lusmdl/MySimRacingCore/README.md

# Sim Racing Core Controller
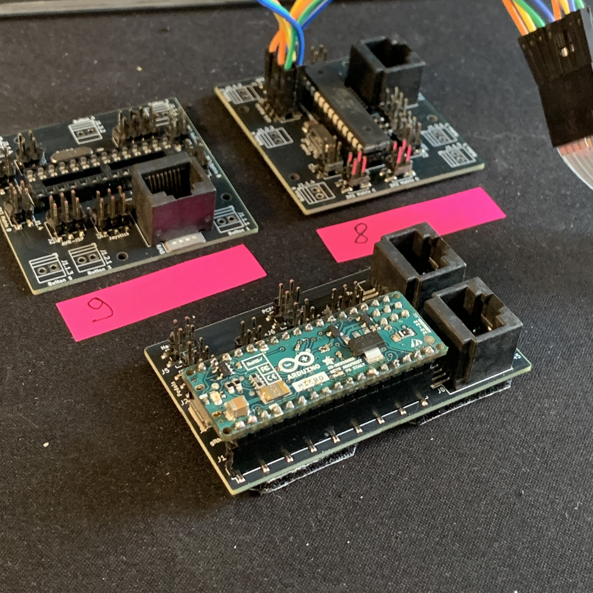
[picture p1: doc/hardware/Pictures/real PCBAs.jpg]
Real PCBA´s


Welcome to the Sim Racing Core Controller repository!

This project focuses on programming the ATmega32u4 microcontroller to serve as the core of a high-performance sim racing setup. 
The controller independently handles all tasks, including steering, pedals, and accessory management, ensuring a streamlined and immersive racing experience—all without external setup software.

Other projects require PC-based software. 
This solution does everything directly on the microcontroller. 
Sensor calibration, configuration, and adjustments are all handled locally and stored in the microcontroller’s memory. 
The system can be operated intuitively via a simple interface.

This repository is designed to prioritize simplicity and reliability, with clean, maintainable code that’s easy to understand and adapt to your needs.

## Features

- 32 buttons (includes joystick button (1) for setup)
- Steering-Axis without FFB (Steering)
- Accelerate-Axis
- Brake-Axis
- X-Rotation-Axis (Joystick)
- Y-Rotation-Axis (Joystick)

## Getting Started

### Hardware Requirements

- **ATmega32u4 Microcontroller**: I use the original arduino micro board
- **Steering Wheel**: I use a cheap optical encoder with A and B line from china
- **Pedals**: I use a old xbox360 racing wheel pedal set. It only needs to work with potis.
- **Buttons**: The microcontroller get the 16 bit data from I2C Interface Adress 8 & 9 button data. You need a diffrent device for this. Look at my other project [here](https://github.com/lusmdl/MySimRacingButtonBox)!
- **Joystick**: I use a "normal" joystick from the Sony DualShock series and have designed a custom PCB to integrate it seamlessly. Special thanks to [little-scale](https://github.com/little-scale) for providing the [PS4 joystick footprint](https://github.com/little-scale/PS4_joystick_footprint), which served as the foundation for my design.
- **LCD**: I use a Arduino Uno with a LCD 2x16 shield. Look at this project [here](https://github.com/lusmdl/MySimRacingSetupDisplay).

> Example PCBs for this project
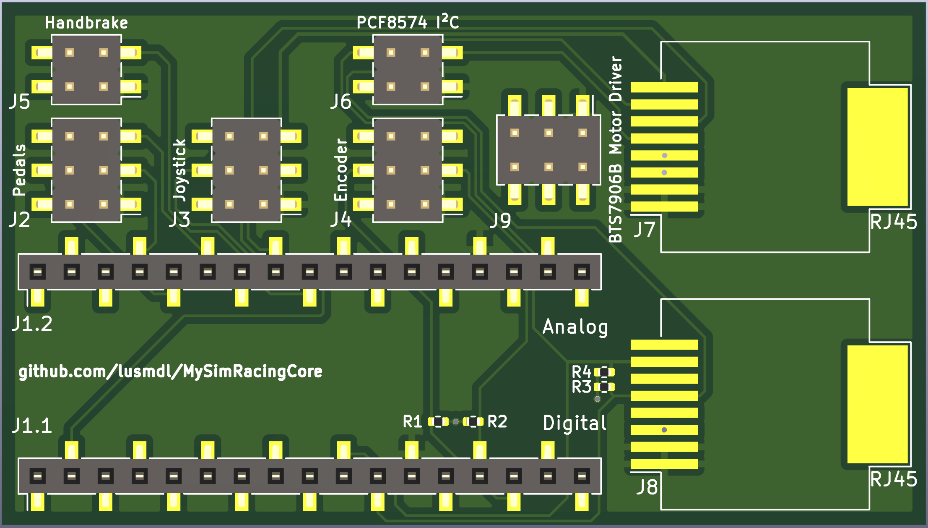
[picture p2: doc/hardware/Pictures/PCBA.png]

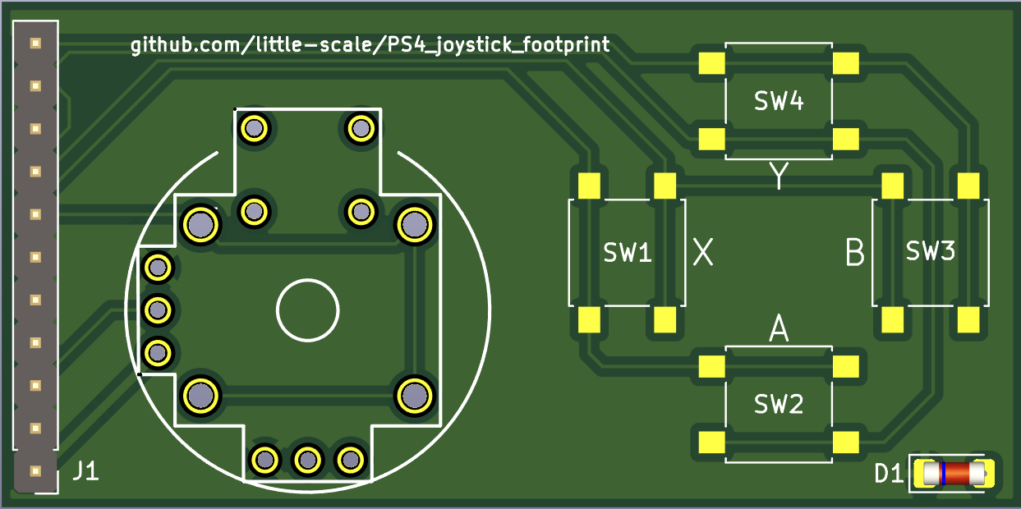
[picture p3: doc/hardware/Pictures/joystick-_PCBA.png]

KiCad-PCB-Design

### Software Requirements

- [**Platform IO**](https://platformio.org/install/ide?install=vscode): Used for programming the ATmega32u4 microcontroller.
- [**AVR Lib**](https://github.com/avrdudes/avr-libc.git): standard lib for programming atmega microcontrollers with platformIO.
- [**Arduino AVR Core**](https://github.com/arduino/ArduinoCore-avr.git): used `Arduino.h`, `Wire.h` and `EEPROM.h`
- [**Arduino Joystick With Force Feedback Library**](https://github.com/YukMingLaw/ArduinoJoystickWithFFBLibrary.git): used for USB communication with the game

### Software Installation and Setup

> You can use the pre compiled hex file. Or you compile it yourself.

1. **Install PlatformIO**:
- Follow the [installation guide](https://platformio.org/install) to set up PlatformIO in your preferred environment (VSCode, Atom, etc.).

2. **Clone the Repository**:

```sh
git clone https://github.com/lusmdl/MySimRacingCore.git
```

3. **Open the Project**:
- Open the cloned repository folder in your PlatformIO environment.

4. **Build and Upload**:
- Connect your Arduino Micro.
- Build and upload the code using PlatformIO:

```sh
pio run --target upload
```

### Hardware Setup

To get started, you’ll need to assemble the accessories and adapt them to the Arduino Micro.

Special attention is required for the I2C interface and the encoder, as proper pull-up resistors are essential for reliable operation. 
To simplify this process, I’ve designed a custom PCB that integrates the Arduino Micro with all necessary accessories and I2C clients.

## Usage

1. **Connecting the Hardware**:
- Connect the accessorys to the Arduino Micro as per your configuration.
- Connect the Arduino Micro to the PC.

2. **Running the Code**:
- Power up your setup.
- The Arduino Micro will continuously push the accessorys states and update the Game data via USB.

3. **Setup the Wheelebase**
- Hit the joystick butten while booting..
- follow the instructions on the lcd

4. **Start your game and try it**

5. **Give feedback and report bugs**

## Documentation
- **Software**: [doc/software/html/index.html](/doc/software/html/index.html)

## Contributing

We welcome contributions from the community!

First, read the [general contributing conventions for projects from me](CONTRIBUTING.md).

1. Fork the repository.
2. Create a new branch (`git checkout -b feature-branch`).
3. Commit your changes (`git commit -am 'Add new feature'`).
4. Push to the branch (`git push origin feature-branch`).
5. Create a new Pull Request.

## License

This project is licensed under the MIT License - see the [LICENSE](LICENSE) file for details.
