lusmdl/MySimRacingCore/doc/hardware/Pin Header 2.54mm THT.pdf

# Artikel-Nr.: 10120184 Bez.: Stiftleiste 50 polig, vergoldet, Raster 2,54mm

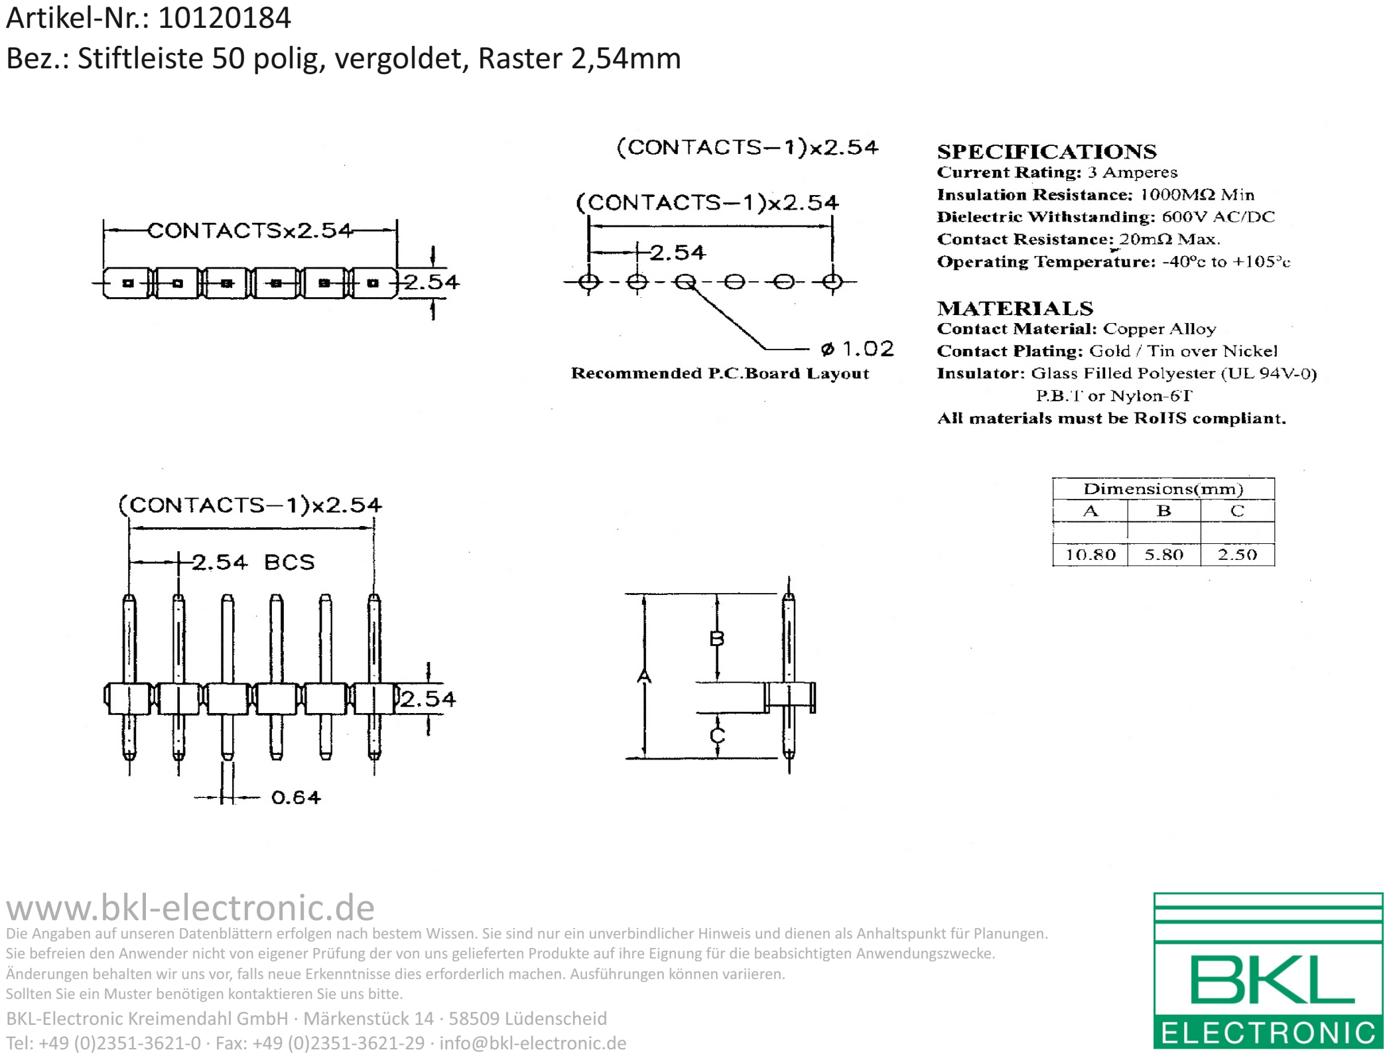
[picture p4: page 1]

# www.bkl-electronic.de

Die Angaben auf unseren Datenblättern erfolgen nach bestem Wissen. Sie sind nur ein unverbindlicher Hinweis und dienen als Anhaltspunkt für Planungen. Sie befreien den Anwender nicht von eigener Prüfung der von uns gelieferten Produkte auf ihre Eignung für die beabsichtigten Anwendungszwecke. Änderungen behalten wir uns vor, falls neue Erkenntnisse dies erforderlich machen. Ausführungen können variieren.
Sollten Sie ein Muster benötigen kontaktieren Sie uns bitte.

### BKL-Electronic Kreimendahl GmbH · Märkenstück 14 · 58509 Lüdenscheid Tel: +49 (0)2351-3621-0 · Fax: +49 (0)2351-3621-29 · info@bkl-electronic.de
