lusmdl/MySimRacingCore/doc/hardware/Socket Header 2.54mm SMD.pdf

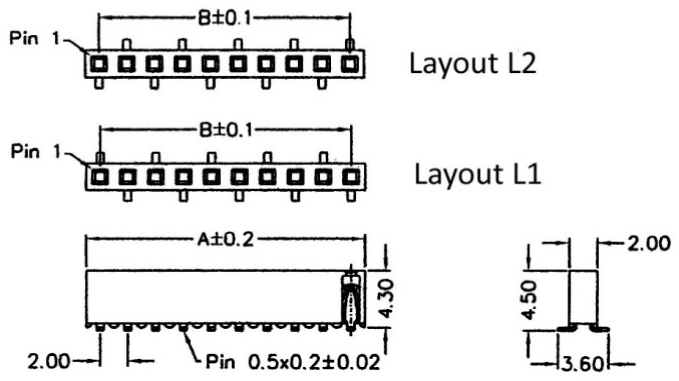
[picture p5: figure]
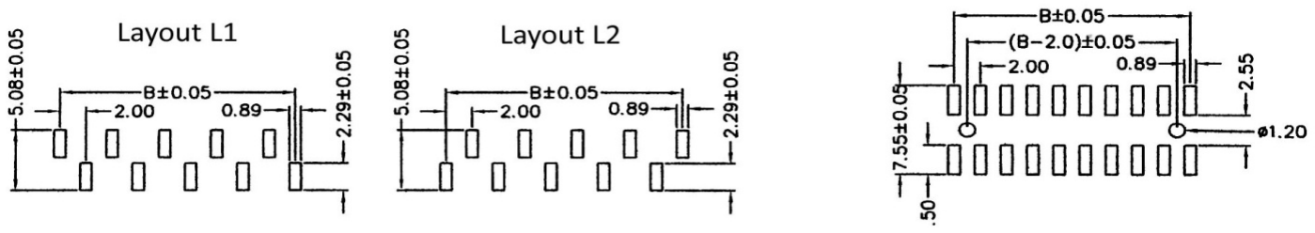
[picture p6: figure]

## Kurzbeschreibung:

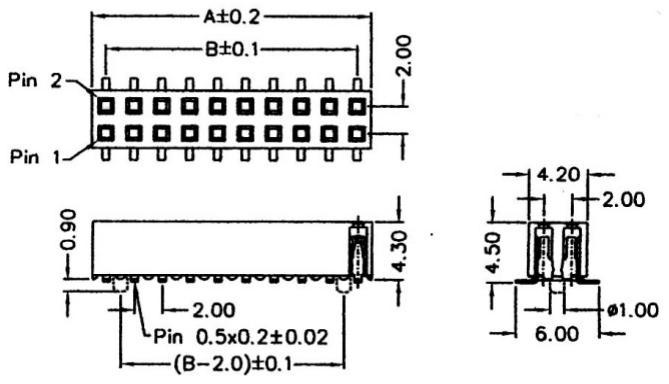
[picture p7: figure]

im Raster 2,00 mm und Bauhöhe = 4,3 mm. Für

## Technische Daten:

Polyester

packung, Tape & Reel

## Lieferform:

Pol, | CSGX, | S‐CSGD

## Passt zu:

S ‐ CP L G 43 | ‐ | ‐ | ‐ P / PP / T / TR

Polzahl pro Reihe (max 50)

‐

ELMEBA GmbH ‐ Am Heintges 9 ‐ D‐40885 Ratingen ‐ www.elmeba.com | Seite 55

Oberfläche: 1 = Verzinnt, 2 = Vergoldet

## SMD Buchsenleiste, RM=2,00 mm, BH= 4,3 mm, für □ 0,5 mm S‐CPLG43

## PCB Layout:

Ein‐ und zweireihige SMD Buchsenleiste
Kontakte □ 0,5 mm und bis max 40 Pole pro Reihe. Wir konfektionieren die Leiste in jede gewünschte Polzahl.
Isolationskörper: | >10 9 GF (UL 94 V‐0) | Isolationswiderstand: | Ω
Vierkantstift: | CuZn36Pb3 | Nennstrom: | 1 Ampere
Oberfläche: | Sn über Ni | Prüfspannung: | 500 V AC
| Au (Flash Au oder 0,75 µ Au) über Ni | Temperaturbereich: | .‐40°C … +105°C
Kontaktwiderstand: | < 10 m Ω | Lötwärmebeständigkeit | 235°C (30 ‐ 60 sec.)
‐ 1x3 ‐ 1x40 Pol, 2x2 ‐ 2x40 | S‐CSGX, CSGD,
‐ andere Raster: z.B. 4,00 mm, 6,00 mm usw | CSAX, S‐CSAX,

‐ jede gewünschte Sondercodierung möglich

‐ Optional: Positionierhilfe, Pick & Place Pads, Stangenver

## Bestellschlüssel:

Anzahl Reihen (1 ‐ 3)

Oberfläche: 1 = Verzinnt, 2 = Vergoldet

Optional: P = Positionierhilfe, PP = Pick & Place Pads, T = Stangenverpackung, TR = Tape & Reel
