lusmdl/MySimRacingCore/doc/hardware/Pin Header 2.54mm SMD.pdf

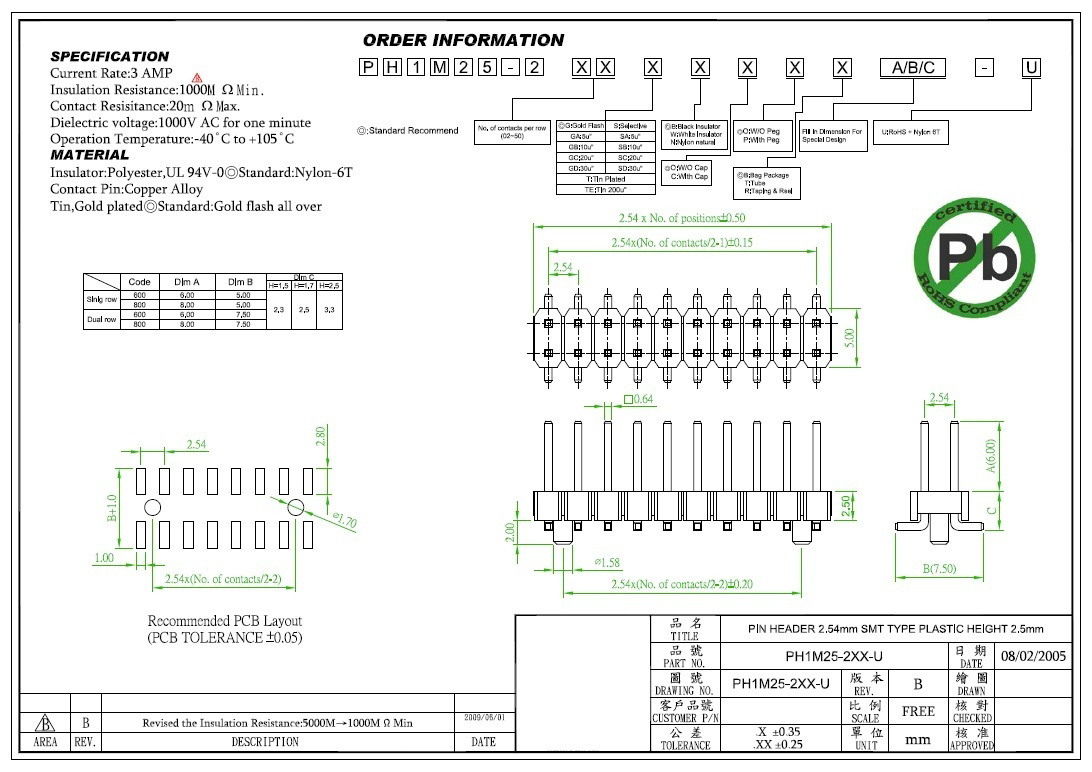
[picture p8: page 1]
