lusmdl/MySimRacingCore/doc/hardware/Hall effect sticks.png

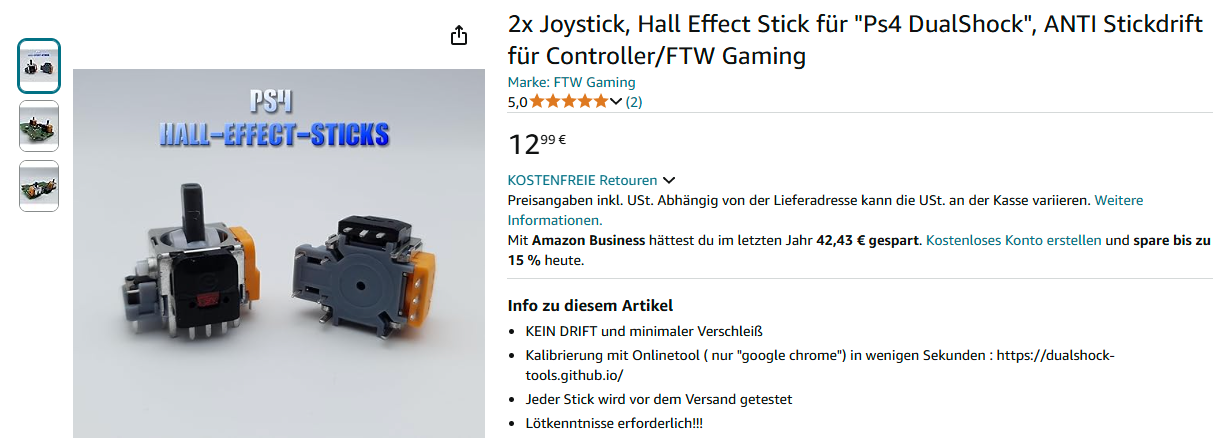
doc/hardware/Hall effect sticks.png
