lusmdl/MySimRacingCore/doc/hardware/HJC0272-011024.pdf

目　　次

## Contents

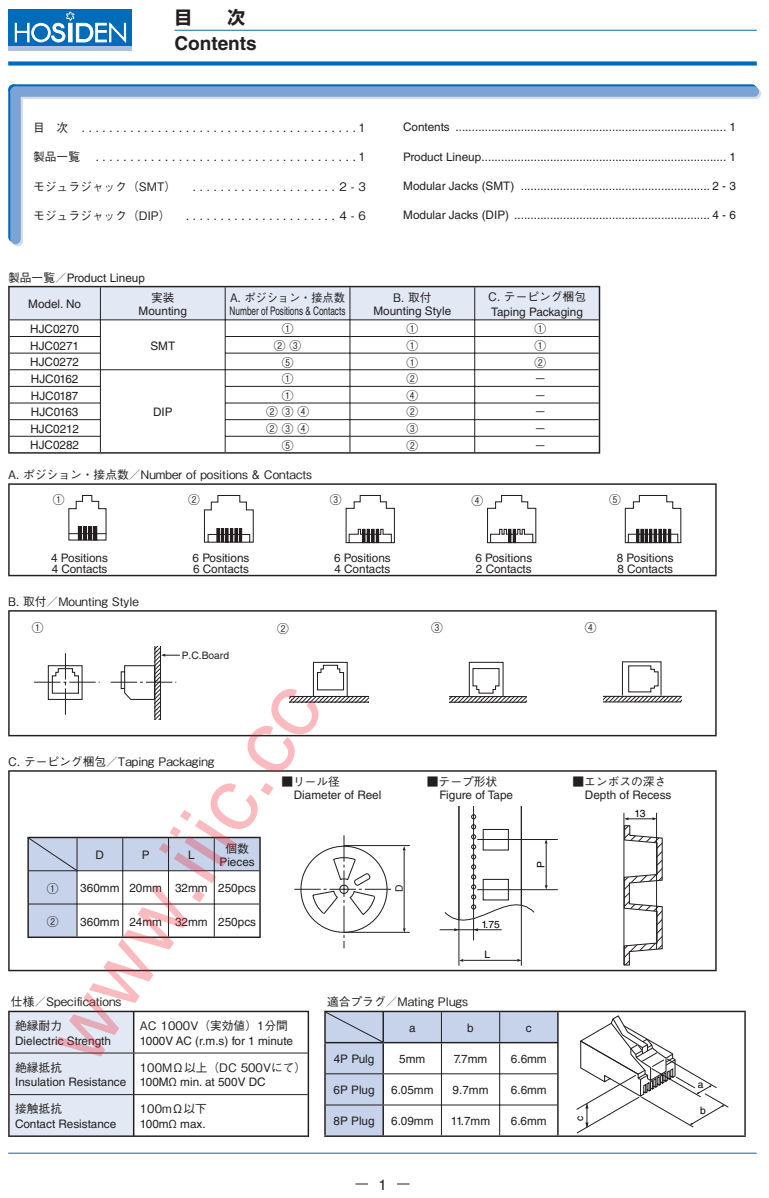
[picture p10: page 1]
絶縁耐力 Dielectric Strength; 絶縁抵抗 Insulation Resistance; 接触抵抗 Contact Resistance; 100mΩ以下 100mΩ max.; モジュラジャック（SMT） . . . . . . . . . . . . . . . . . . . . . 2 - 3; モジュラジャック（DIP） . . . . . . . . . . . . . . . . . . . . . . 4 - 6; 4 Positions 4 Contacts; 6 Positions 6 Contacts; 6 Positions 4 Contacts; 6 Positions 2 Contacts; 8 Positions 8 Contacts; P.C.Board

Modular Jacks (SMT) .......................................................... 2 - 3

Modular Jacks (DIP) ............................................................ 4 - 6

製品一覧／Product Lineup

Model. No | 実装 Mounting | A. ポジション・接点数 Number of Positions & Contacts | B. 取付 Mounting Style | C. テーピング梱包 Taping Packaging

HJC0270 | SMT | ① | ① | ①
HJC0271 | | ② ③ | ① | ①
HJC0272 | | ⑤ | ① | ②
HJC0162 | DIP | ① | ② | －
HJC0187 | | ① | ④ | －
HJC0163 | | ② ③ ④ | ② | －
HJC0212 | | ② ③ ④ | ③ | －
HJC0282 | | ⑤ | ② | －

A. ポジション・接点数／Number of positions & Contacts
13 www.iiic.cc

B. 取付／Mounting Style

C. テーピング梱包／Taping Packaging

■リール径
Diameter of Reel

■テープ形状
Figure of Tape

■エンボスの深さ
Depth of Recess

D | P | L | 個数 Pieces

① | 360mm | 20mm | 32mm | 250pcs

② | 360mm | 24mm | 32mm | 250pcs

仕様／Specifi cations

適合プラグ／Mating Plugs

AC 1000V（実効値）1分間
1000V AC (r.m.s) for 1 minute

4P Pulg | 5mm | 7.7mm | 6.6mm

100MΩ以上（DC 500Vにて）
100MΩ min. at 500V DC

6P Plug | 6.05mm | 9.7mm | 6.6mm

8P Plug | 6.09mm | 11.7mm | 6.6mm

## モジュラジャック（SMT）

## Modular Jacks (SMT)

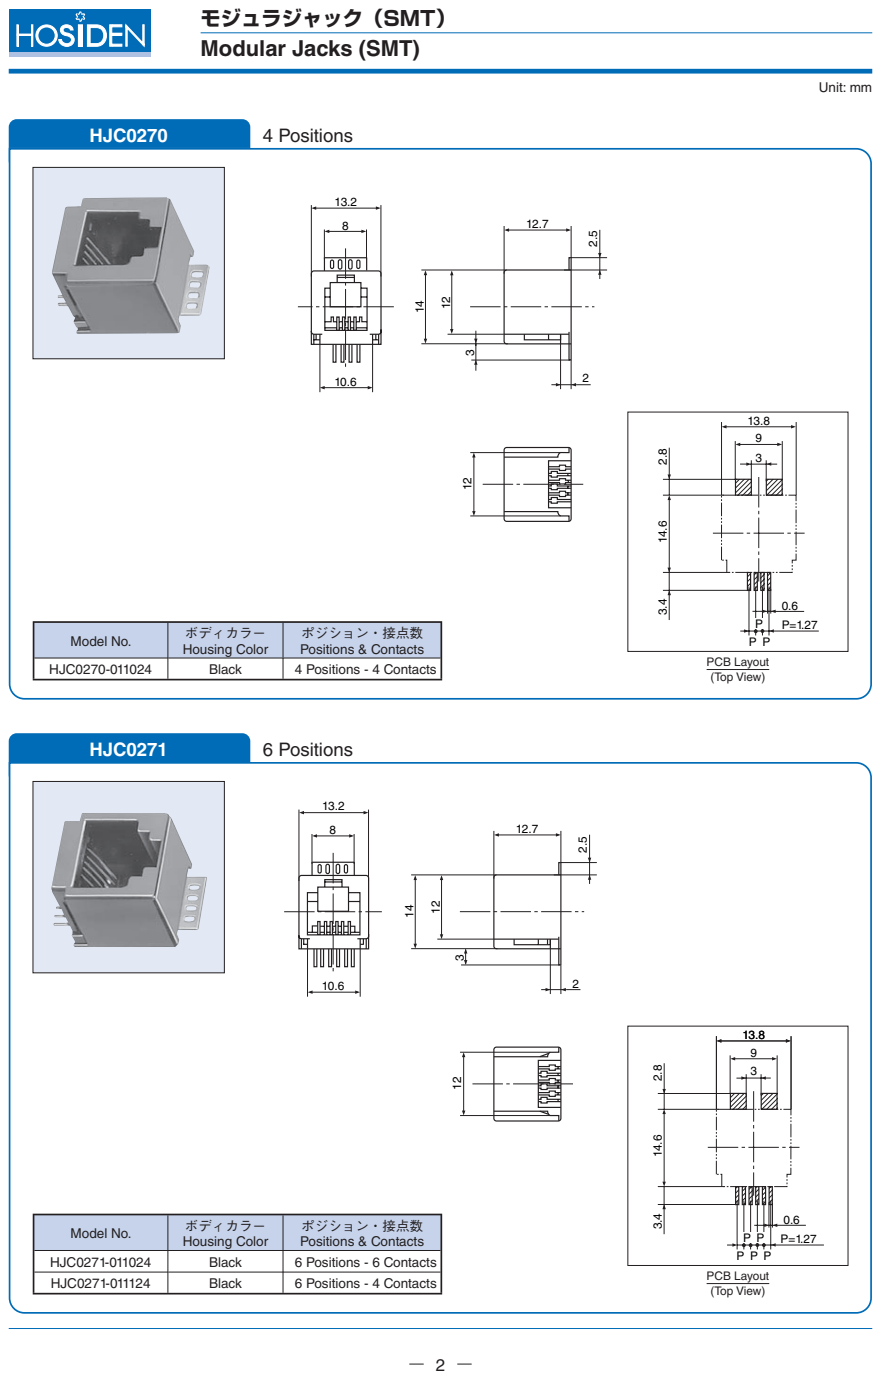
[picture p11: page 2]
Unit: mm; HJC0271; PCB Layout (Top View); HJC0270; 4 Positions; 6 Positions

Model No. | ボディカラー Housing Color | ポジション・接点数 Positions & Contacts

HJC0270-011024 | Black 4 Positions - 4 Contacts

HJC0271-011024 | Black | 6 Positions - 6 Contacts
HJC0271-011124 | Black | 6 Positions - 4 Contacts

## モジュラジャック（SMT）

## Modular Jacks (SMT)

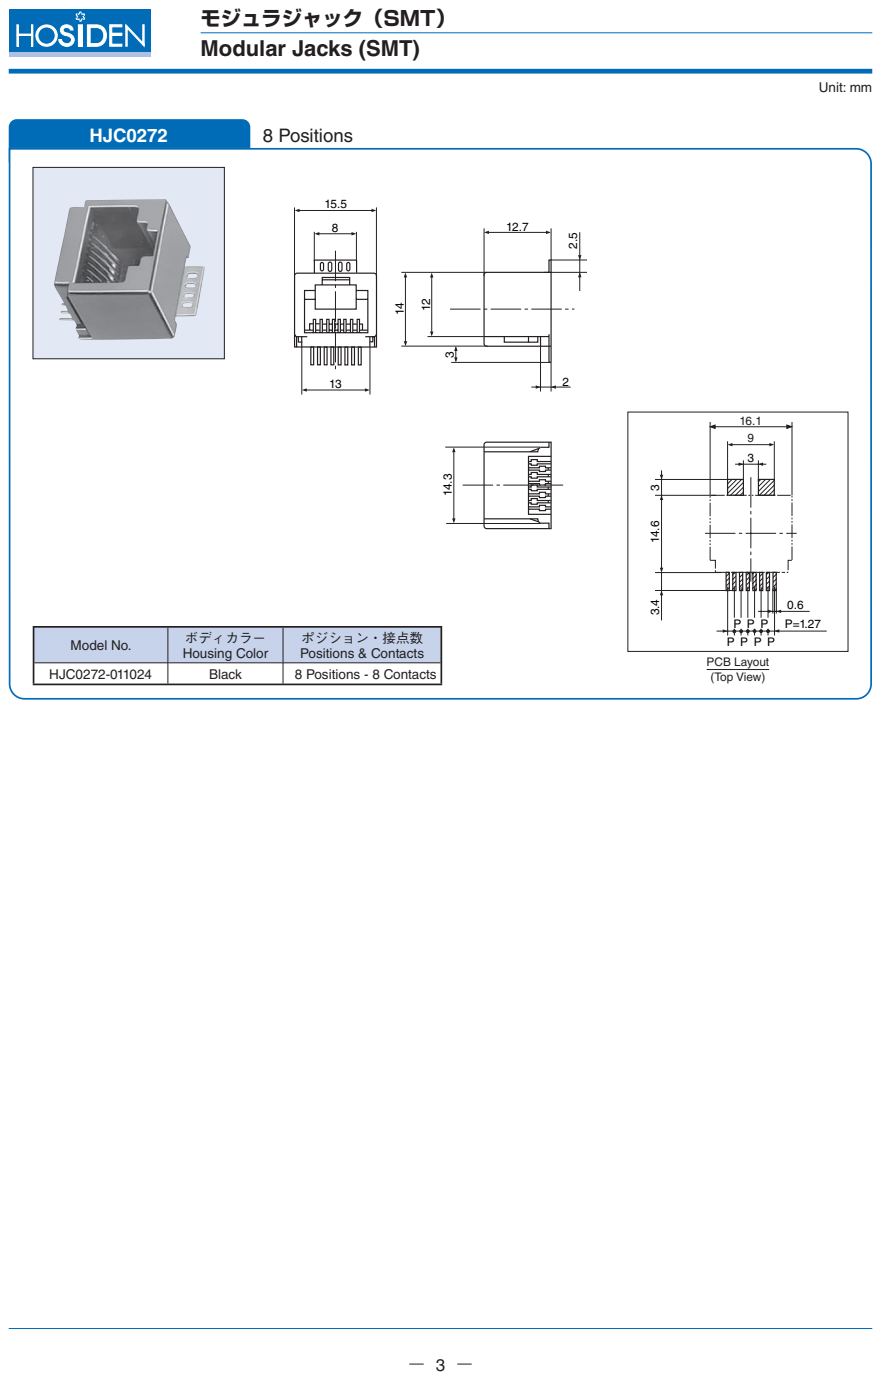
[picture p12: page 3]
8 Positions; HJC0272; PCB Layout (Top View)

Model No. | ボディカラー Housing Color | ポジション・接点数 Positions & Contacts

HJC0272-011024 | Black 8 Positions - 8 Contacts

## モジュラジャック（DIP）

## 4 Positions

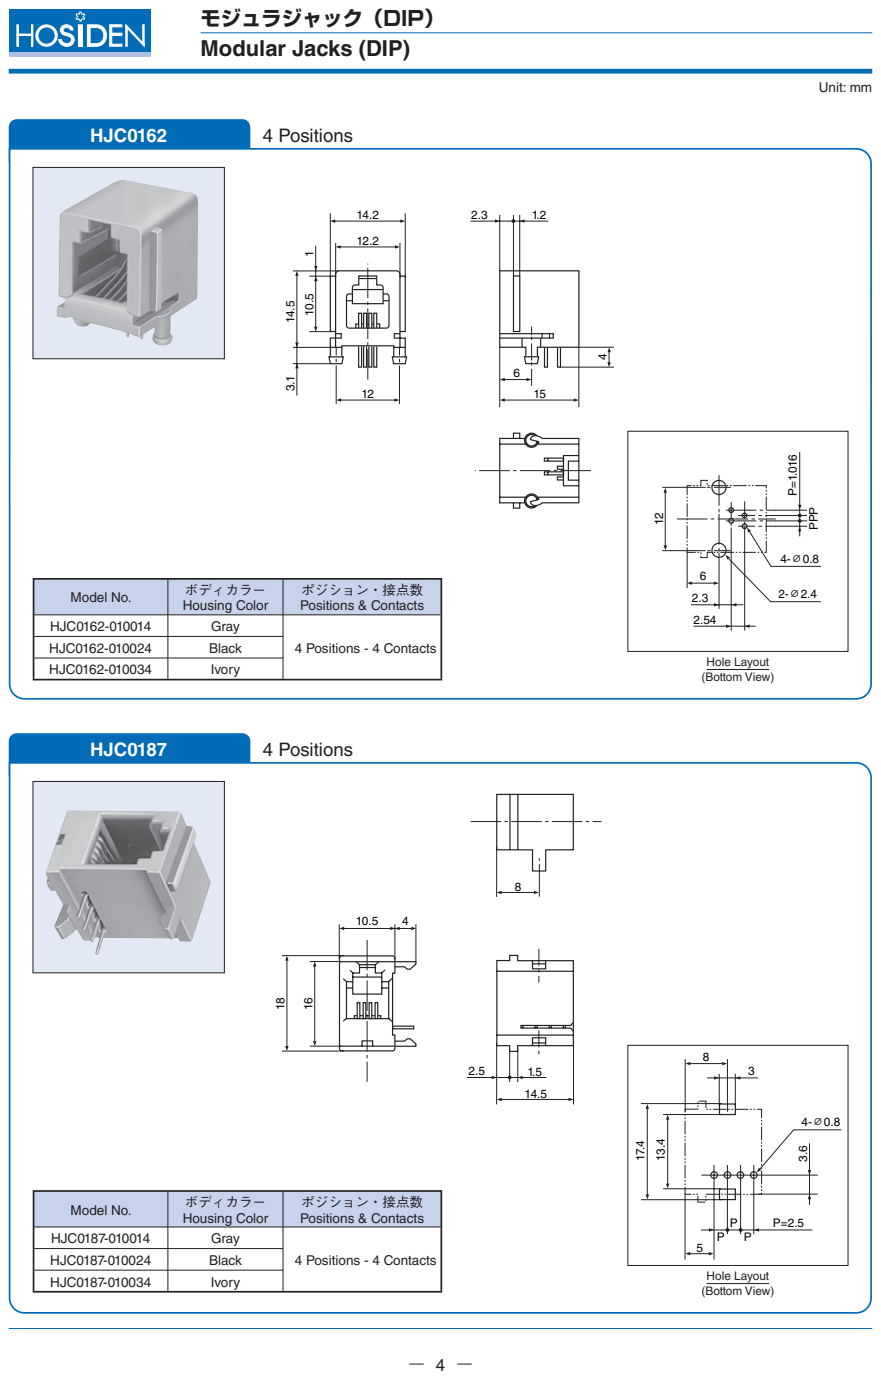
[picture p13: page 4]
Modular Jacks (DIP) 14.5; HJC0162; HJC0187; Hole Layout (Bottom View); 4 Positions

Model No. | ボディカラー Housing Color | ポジション・接点数 Positions & Contacts

HJC0162-010014 | Gray | 4 Positions - 4 Contacts
HJC0162-010024 | Black
HJC0162-010034 | Ivory

HJC0187-010014 | Gray | 4 Positions - 4 Contacts
HJC0187-010024 | Black
HJC0187-010034 | Ivory

## Modular Jacks (DIP)

## 6 Positions

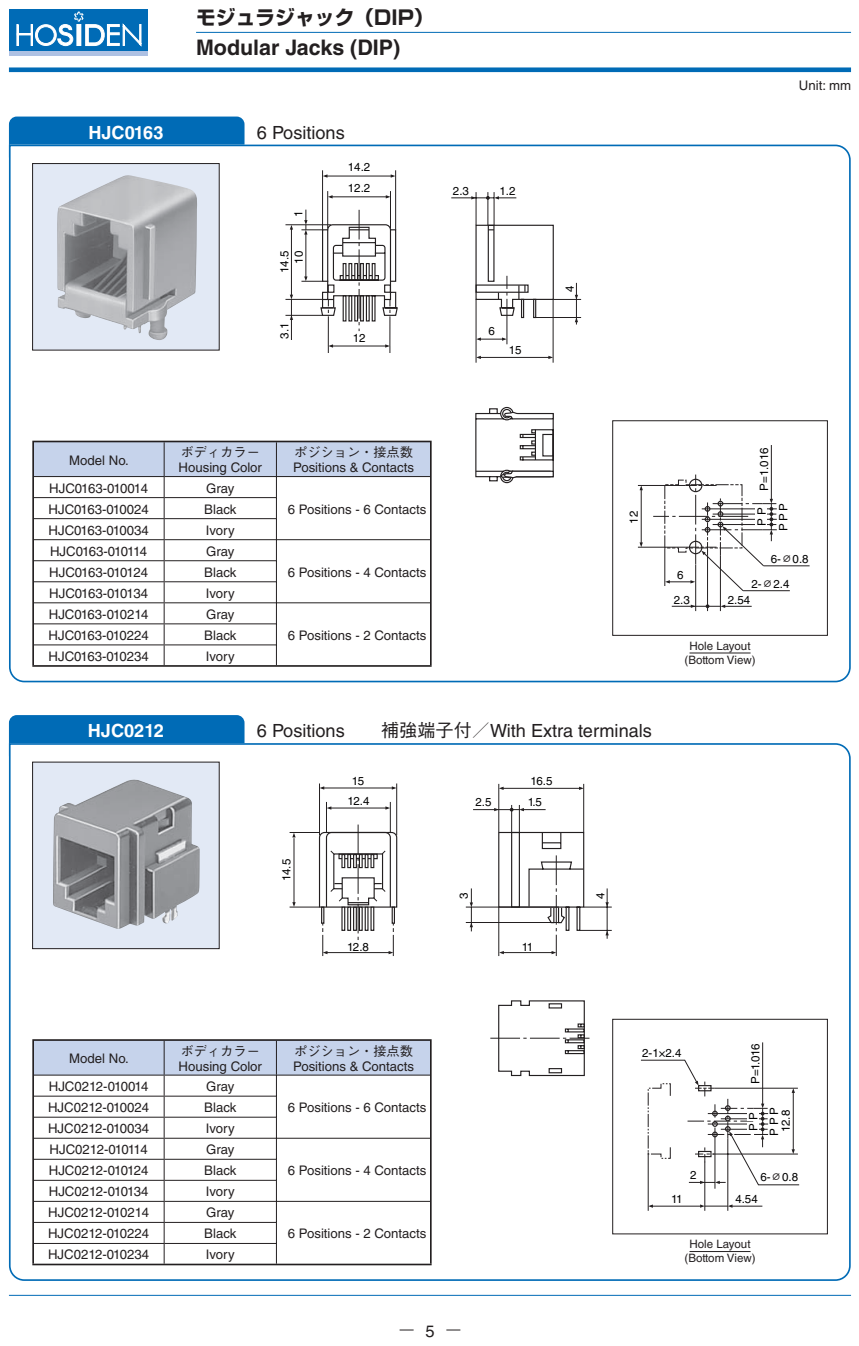
[picture p14: page 5]
HJC0163; HJC0212; 6 Positions 補強端子付／With Extra terminals; Hole Layout (Bottom View)

Model No. | ボディカラー Housing Color | ポジション・接点数 Positions & Contacts

HJC0163-010014 | Gray | 6 Positions - 6 Contacts
HJC0163-010024 | Black
HJC0163-010034 | Ivory
HJC0163-010114 | Gray | 6 Positions - 4 Contacts
HJC0163-010124 | Black
HJC0163-010134 | Ivory
HJC0163-010214 | Gray | 6 Positions - 2 Contacts
HJC0163-010224 | Black
HJC0163-010234 | Ivory

HJC0212-010014 | Gray | 6 Positions - 6 Contacts
HJC0212-010024 | Black
HJC0212-010034 | Ivory
HJC0212-010114 | Gray | 6 Positions - 4 Contacts
HJC0212-010124 | Black
HJC0212-010134 | Ivory
HJC0212-010214 | Gray | 6 Positions - 2 Contacts
HJC0212-010224 | Black
HJC0212-010234 | Ivory

## Modular Jacks (DIP)

HJC0282 | 8 Positions

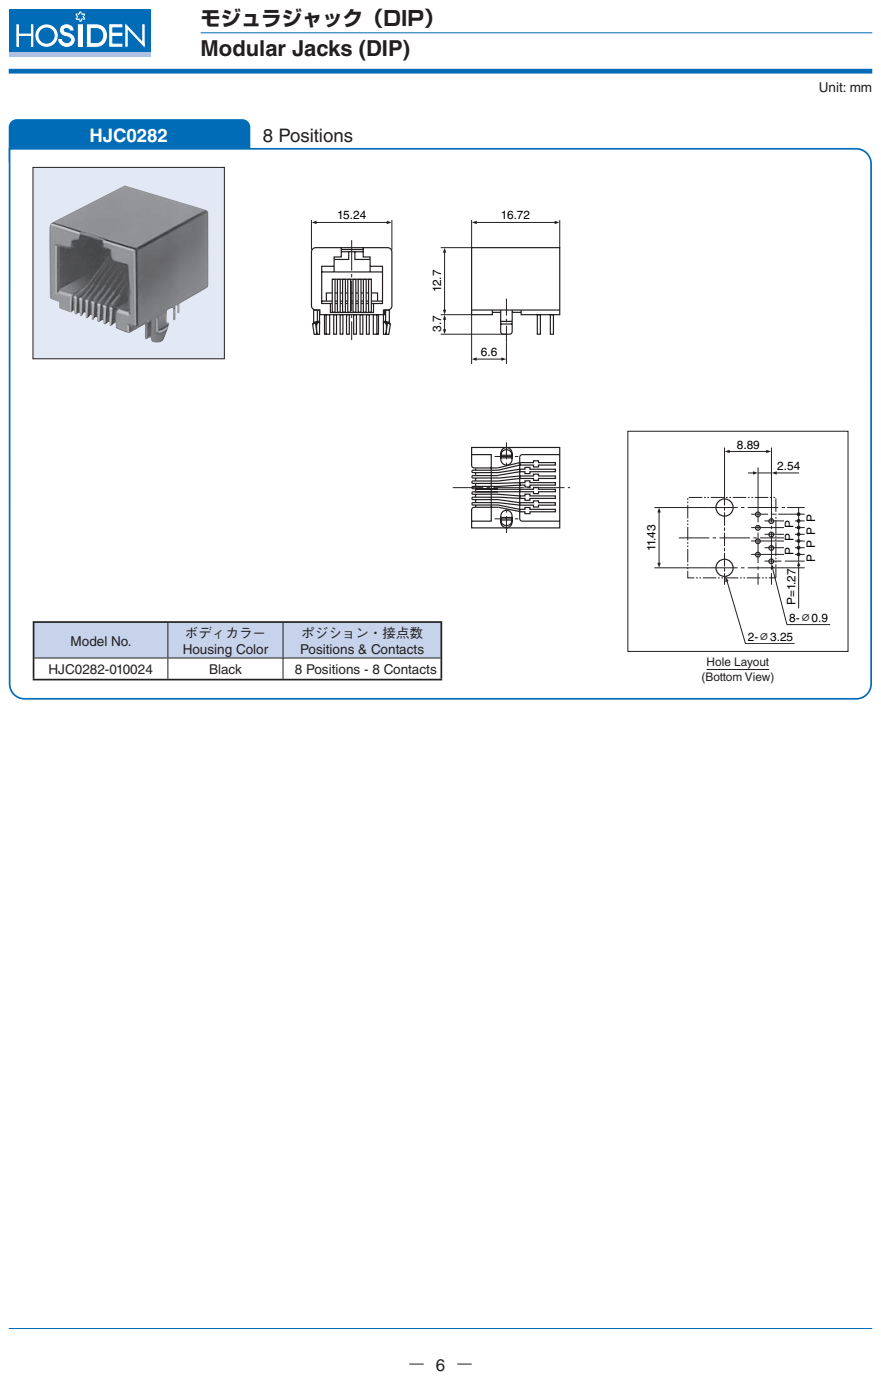
[picture p15: page 6]
Hole Layout (Bottom View)

Model No. | ボディカラー Housing Color | ポジション・接点数 Positions & Contacts

HJC0282-010024 | Black 8 Positions - 8 Contacts

ご使用の際は、納入仕様書を確認の上、正しく お使いください。 | Please use our products properly based on our Drawing and Specification.

### JC06 モジュラジャック

Modular Jacks

### ■Model No. Table

Model No. | Page
H J C 0 1 6 2 | 4
H J C 0 1 6 3 | 5
H J C 0 1 8 7 | 4
H J C 0 2 1 2 | 5
H J C 0 2 7 0 | 2
H J C 0 2 7 1 | 2
H J C 0 2 7 2 | 3
H J C 0 2 8 2 | 6
