lusmdl/MySimRacingCore/doc/hardware/Micro_Rev1j_sch.pdf

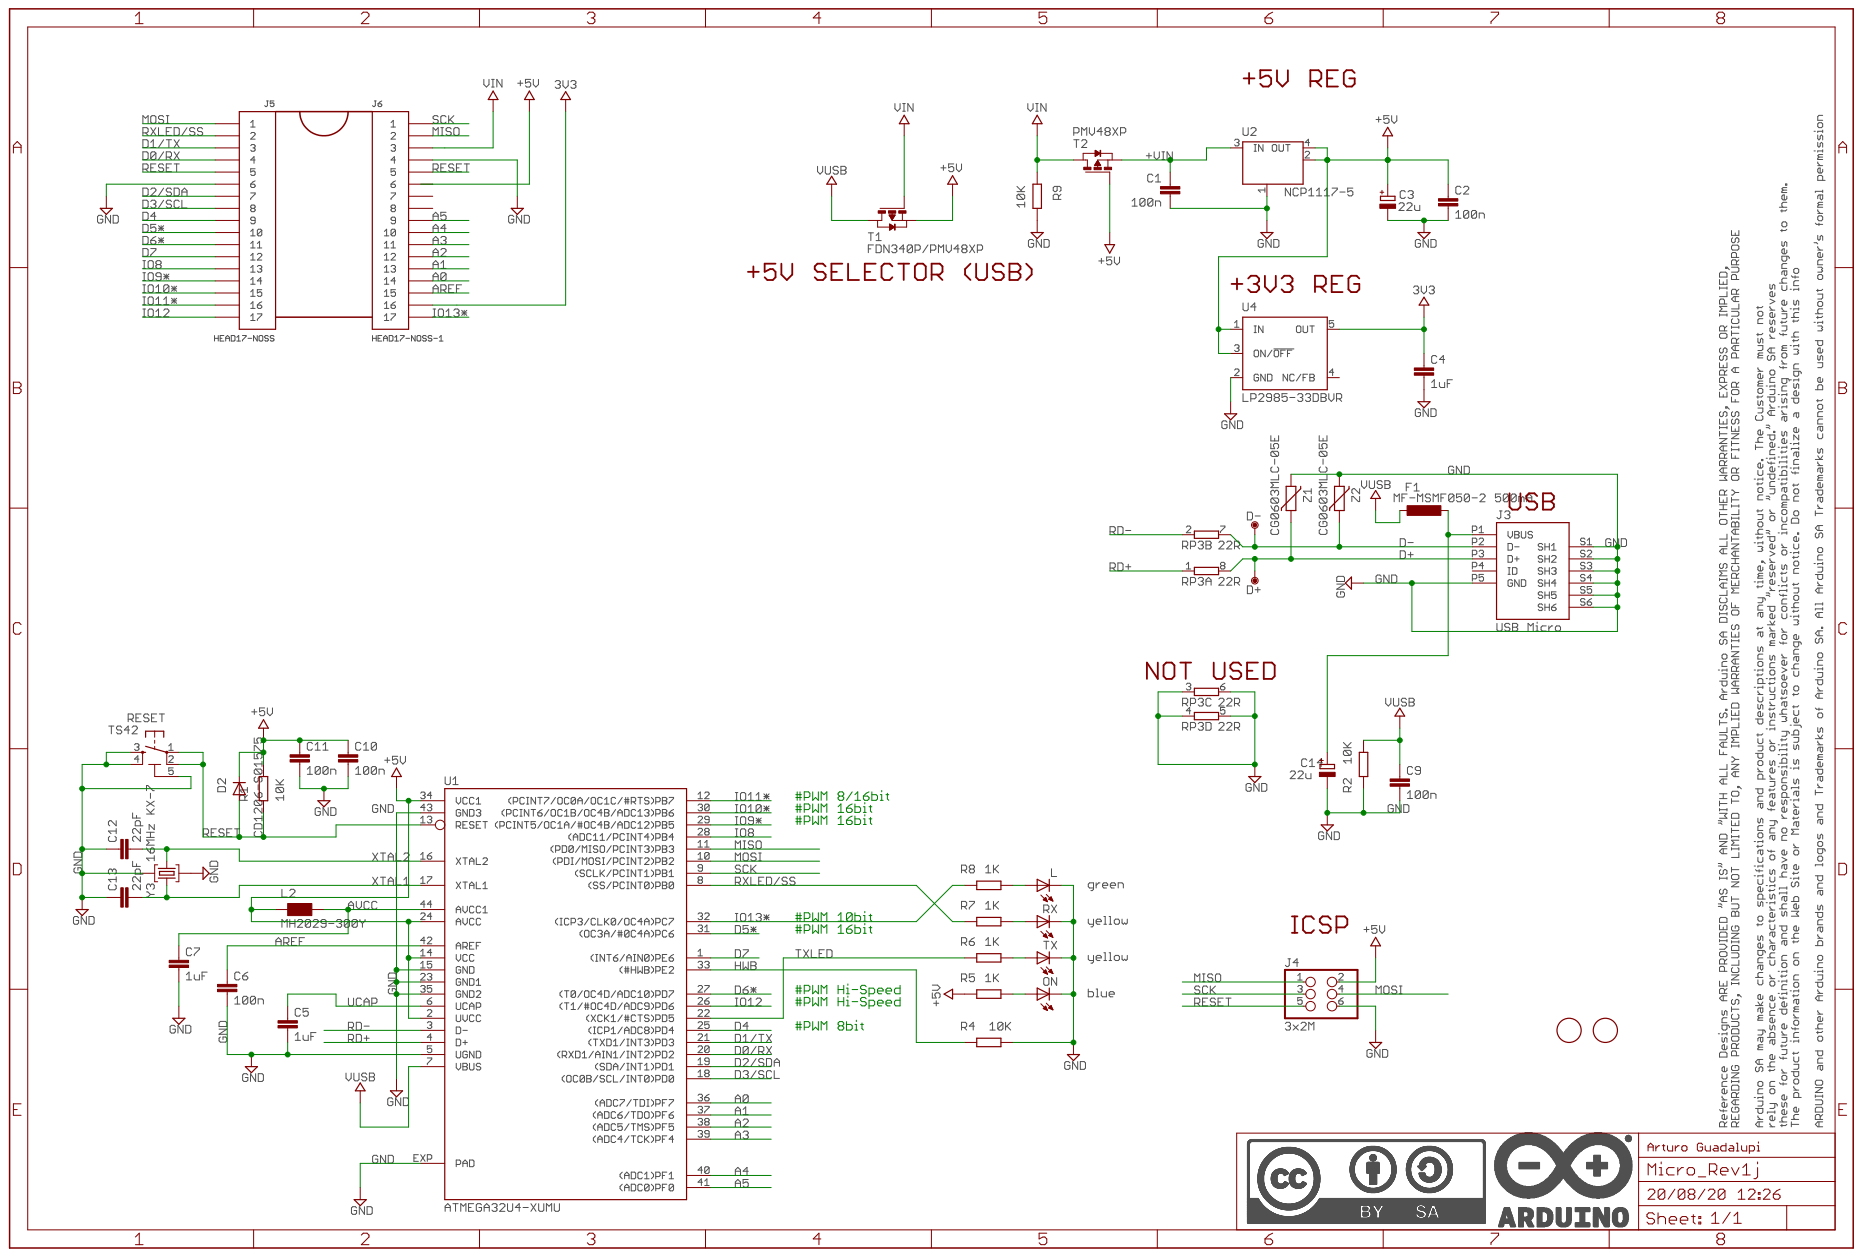
[picture p16: page 1]
