lusmdl/MySimRacingCore/kicad/circuit/circuit.kicad_pcb

## KiCad design kicad/circuit/circuit.kicad_pcb (2025-05-10)

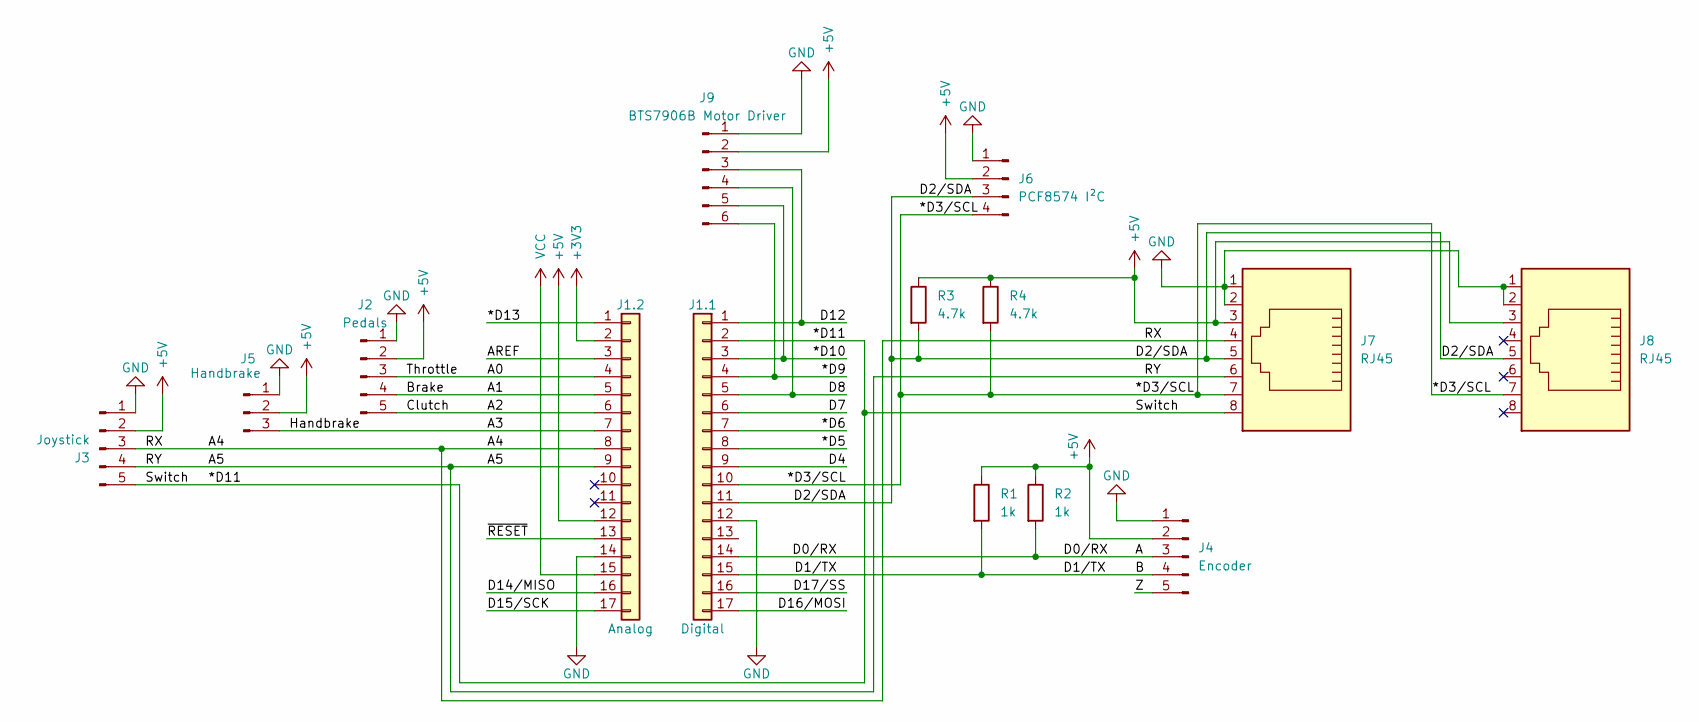
[picture p17: schematic circuit.kicad_sch, Arduino Micro Board]

Parts:
J1.1: Digital; PinSocket_1x17_P2.54mm_Vertical_SMD_Pin1Left
J1.2: Analog; PinSocket_1x17_P2.54mm_Vertical_SMD_Pin1Left
J2: Pedals; PinHeader_2x03_P2.54mm_Vertical_SMD
J3: Joystick; PinHeader_2x03_P2.54mm_Vertical_SMD
J4: Encoder; PinHeader_2x03_P2.54mm_Vertical_SMD
J5: Handbrake; PinHeader_2x02_P2.54mm_Vertical_SMD
J6: PCF8574 I²C; PinHeader_2x02_P2.54mm_Vertical_SMD
J7, J8: RJ45; RJ45_Molex_0855135013_Vertical
J9: BTS7906B Motor Driver; PinHeader_2x03_P2.54mm_Vertical_SMD
R1, R2: 1k; R_0402_1005Metric
R3, R4: 4.7k; R_0402_1005Metric

Connections:
+3V3: J1.2.2
+5V: J1.2.12, J2.2, J3.2, J4.2, J5.2, J6.2, J7.3, J8.3, J9.2, R1.1, R2.1, R3.1, R4.1
/*D3/SCL: J1.1.10, J6.4, J7.7, J8.7, R4.2
/*D5: J1.1.8
/*D6: J1.1.7
/*D9: J1.1.4, J9.6
/*D10: J1.1.3, J9.5
/*D11: J1.1.2, J3.5, J7.8
/*D13: J1.2.1
/A: J1.1.14, J4.3, R2.2
/A0: J1.2.4, J2.3
/A1: J1.2.5, J2.4
/A2: J1.2.6, J2.5
/A3: J1.2.7, J5.3
/A4: J1.2.8, J3.3, J7.4
/A5: J1.2.9, J3.4, J7.6
/AREF: J1.2.3
/B: J1.1.15, J4.4, R1.2
/D2/SDA: J1.1.11, J6.3, J7.5, J8.5, R3.2
/D4: J1.1.9
/D7: J1.1.6
/D8: J1.1.5, J9.4
/D12: J1.1.1, J9.3
/D14/MISO: J1.2.16
/D15/SCK: J1.2.17
/D16/MOSI: J1.1.17
/D17/SS: J1.1.16
/Z: J4.5
/~RESET: J1.2.13
GND: J1.1.12, J1.2.14, J2.1, J3.1, J4.1, J5.1, J6.1, J7.1, J7.2, J8.1, J8.2, J9.1
VCC: J1.2.15

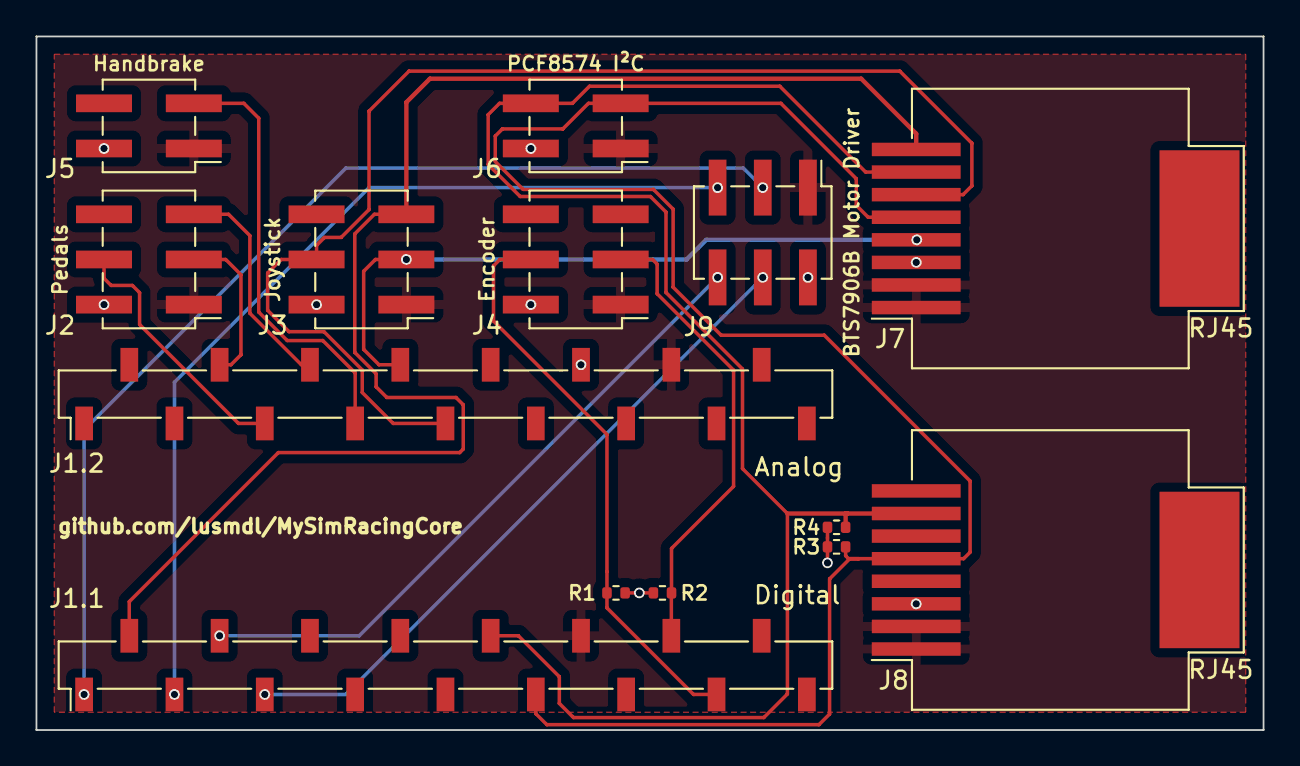
[picture p18: board circuit.kicad_pcb from above]

Board: 2 copper layers, 69.0 x 39.0 mm, 14 parts (0 on the bottom side), 17 nets.
