lusmdl/MySimRacingCore/kicad/PS4_joystick_footprint/ps4.kicad_pcb

## KiCad design kicad/PS4_joystick_footprint/ps4.kicad_pcb (2025-05-10)

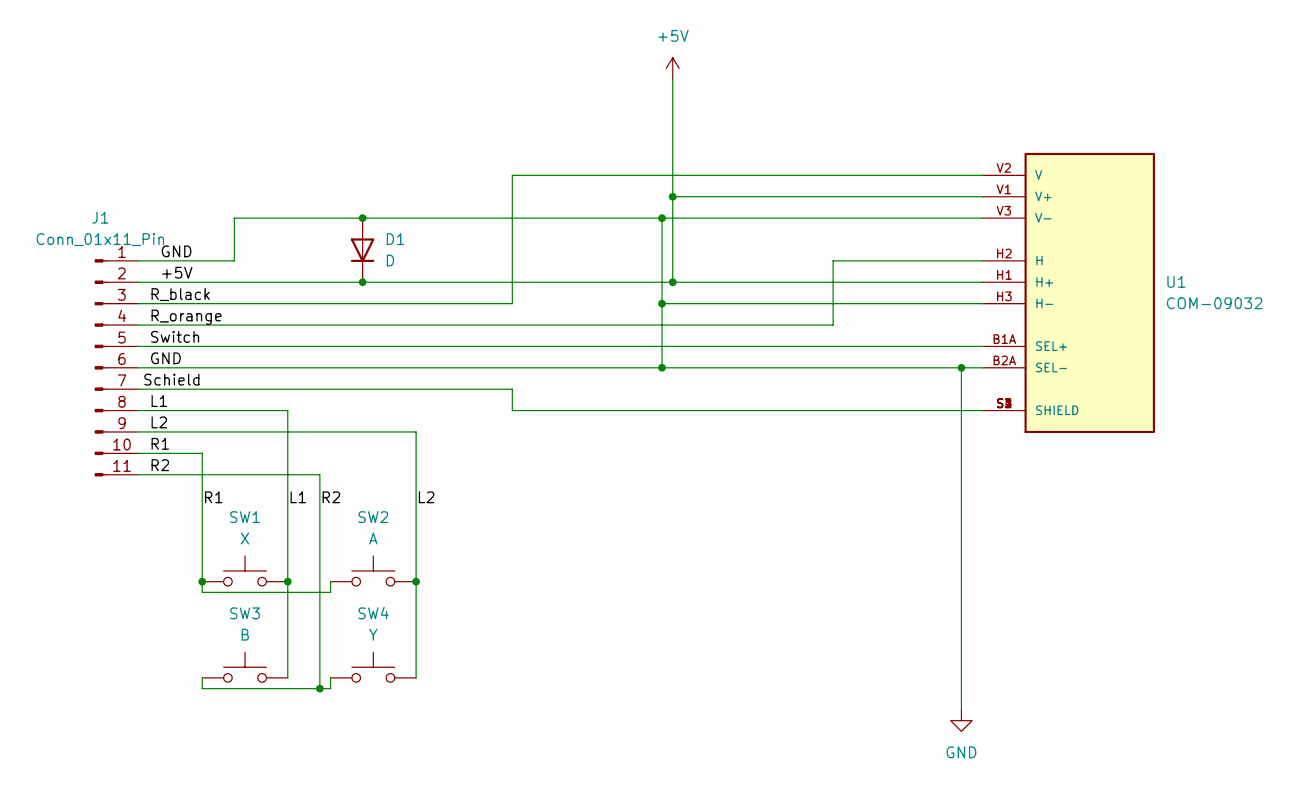
[picture p19: schematic ps4.kicad_sch, PS4 Joystick with buttons PCB]

Parts:
D1: D; D_MiniMELF
J1: Conn_01x11_Pin; PinHeader_1x11_P2.54mm_Vertical
SW1: X; SW_SPST_B3S-1000
SW2: A; SW_SPST_B3S-1000
SW3: B; SW_SPST_B3S-1000
SW4: Y; SW_SPST_B3S-1000
U1: COM-09032; PS4_joystick; PARTREV N/A

Connections:
+5V: D1.1 (K), J1.2, U1.H1 (H+), U1.V1 (V+)
/L1: J1.8, SW1.2, SW3.2
/L2: J1.9, SW2.2, SW4.2
/R1: J1.10, SW1.1, SW2.1
/R2: J1.11, SW3.1, SW4.1
/R_black: J1.3, U1.V2 (V)
/R_orange: J1.4, U1.H2 (H)
/Schield: J1.7, U1.S1 (SHIELD), U1.S2 (SHIELD), U1.S3 (SHIELD), U1.S4 (SHIELD)
/Switch: J1.5, U1.B1A (SEL+)
GND: D1.2 (A), J1.1, J1.6, U1.B2A (SEL-), U1.H3 (H-), U1.V3 (V-)

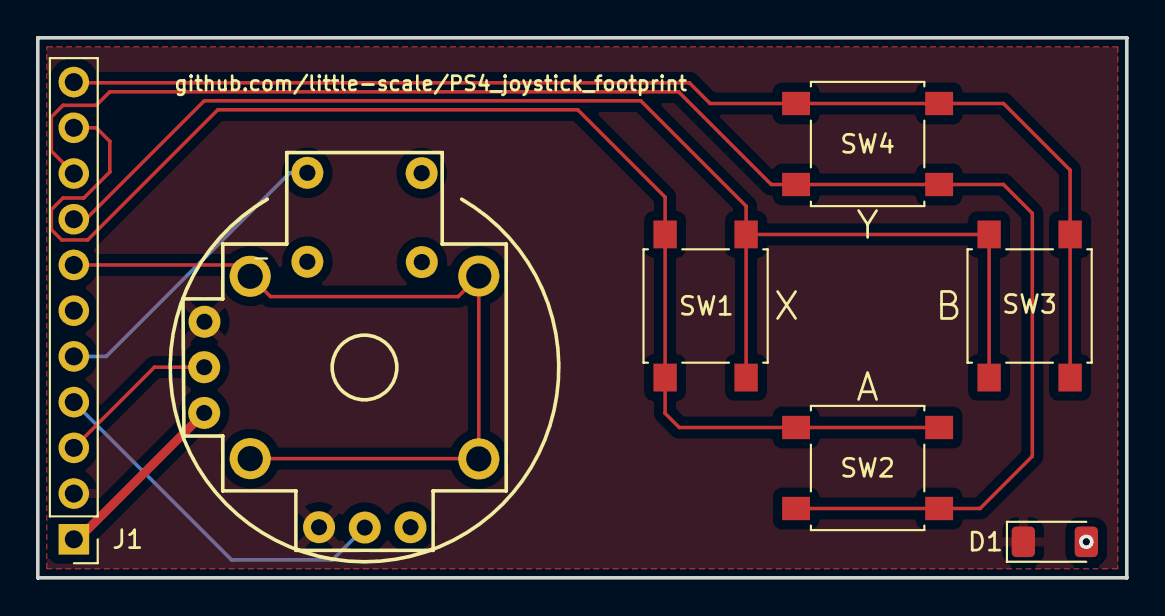
[picture p20: board ps4.kicad_pcb from above]

Board: 2 copper layers, 60.5 x 30.0 mm, 7 parts (0 on the bottom side), 10 nets.
