lusmdl/MySimRacingCore/include/EepromAdresses.h

/**
 * @file EepromAdresses.h
 * 
 * @brief Definition of eeprom adresses
 */

 #ifndef EEPROM_ADRESSES_H
 #define EEPROM_ADRESSES_H

 #define STORE_ADDR_RX_MAX              0
 #define STORE_ADDR_RX_MIN              16
 #define STORE_ADDR_RY_MAX              32
 #define STORE_ADDR_RY_MIN              48
 #define STORE_ADDR_FACTOR              64
 #define STORE_ADDR_THROTTLE_MAX        96
 #define STORE_ADDR_THROTTLE_MIN        112
 #define STORE_ADDR_BRAKE_MAX           128
 #define STORE_ADDR_BRAKE_MIN           144
 #define STORE_ADDR_RX_CENTER           160
 #define STORE_ADDR_RY_CENTER           176


 #endif
