lusmdl/MySimRacingCore/include/TextBoxes.h

#ifndef TEXT_BOXES_H
#define TEXT_BOXES_H

#define TXT_DONE        "done            "
#define TXT_BOOTING     "booting..       "
#define TXT_BOOT_DONE   "booting..success"
#define TXT_DEBUG       "debug mode      "
#define TXT_RESET       "hit reset button"
#define TXT_CLEAR       "                "
#define TXT_JOYSTICK    "release joystick"

#endif
