lusmdl/MySimRacingCore/src/Core/Buttons.cpp

/**
 * @file Buttons.cpp
 * @brief Implementation of the Buttons class.
 */

#include "Buttons.hpp"

/**
 * @brief Constructor for Buttons class.
 * 
 * Initializes the row and column pins, key array, and keypad object.
 */
Buttons::Buttons(TwoWire &wire) :
    wire_(&wire)
{}

/**
 * @brief Destructor for Buttons class.
 * 
 * No dynamic memory allocation is required.
 */
Buttons::~Buttons() {

    //delete wire_;
}

/**
 * @brief Listens and processes key presses.
 * 
 * Polls the keypad and processes key press events. Updates the data_ array with key press counts.
 */
void Buttons::listener() {

    //constexpr uint8_t TWI_MSG_BYTES {2};
        
    uint8_t byte;

    // Device 1

    wire_->requestFrom(TWI_ADDR_MY_WHEEL_BTN, TWI_MSG_BYTES);
    
    if (wire_->available() == TWI_MSG_BYTES) {

        byte = wire_->read(); // Receive the first byte

        for (int i = 0; i < 8; ++i) {

            // Map the received bytes to the button data structure

            data_[i].pushed = (byte & (1 << i)) ? 1 : 0;
        }

        byte = wire_->read(); // Receive the second byte

        for (int i = 0; i < 8; ++i) {

            // Map the received bytes to the button data structure

            data_[8 + i].pushed = (byte & (1 << i)) ? 1 : 0;
        }
    }

    // Device 2

    wire_->requestFrom(TWI_ADDR_MY_BTN_BOX, TWI_MSG_BYTES); 
    
    if (wire_->available() == TWI_MSG_BYTES) {

        byte = wire_->read(); // Receive the first byte
        
        for (int i = 0; i < 8; ++i) {
            
            // Map the received bytes to the button data structure

            data_[16 + i].pushed = (byte & (1 << i)) ? 1 : 0;
        }

        byte = wire_->read(); // Receive the second byte

        for (int i = 0; i < 8; ++i) {
            
            // Map the received bytes to the button data structure

            data_[24 + i].pushed = (byte & (1 << i)) ? 1 : 0; // Map each bit to a button state
        }
    }
        
}

/**
 * @brief Gets the data of a specific button.
 * 
 * @param button The button index.
 * @return pod_button The data of the specified button.
 */
pod_button Buttons::getData(uint8_t button) {

    return data_[button];
}
