lusmdl/MySimRacingCore/src/Core/ComUsb.hpp

/**
 * @file ComUsb.hpp
 * @brief Definition of the ComUsb class.
 */

#ifndef COM_USB_HPP
#define COM_USB_HPP

#include "ProjectConfig.hpp"
#include "Joystick.h"
#include "Buttons.hpp"
#include "Joyst.hpp"
#include "Pedals.hpp"
#include "Encoder.hpp"

#ifdef LUSMDL_DEBUGMODE
#include <WString.h>
#include <Arduino.h>
#endif

class ComUsb {
    
    public:

        ComUsb(Buttons &btns, Joyst &joyst, Pedals &pedal, Encoder &encoder);
        ~ComUsb();
        void begin();
        void sendData();
        void receiveData();
        
        private:
        
        Buttons *btns_;
        Joyst *joyst_;
        Pedals *pedal_;
        Encoder *encoder_;
        
        Joystick_ joy_;
        
        
        //static const int16_t AXIS_MIN_USB = -32768;
        //static const int16_t AXIS_MAX_USB = 32767;
        
        int16_t calculateAxis(pod_axis data);
};

#endif // COM_USB_HPP
