lusmdl/MySimRacingCore/(commit log)

2024-07-09 reorder the files and add buttons class
2024-07-09 add code for button matrix. This needs to be tested!
2024-07-10 use keypad.h lib for the buttons.
2024-07-11 buttons finaly works
2024-07-11 add encoder (not tested)
2024-07-14 implement the joystick axis, the joystick button is still missing. But the axis works
    [ADCAxis.cpp, ADCAxis.hpp, ComUsb.cpp, ComUsb.hpp, Joyst.cpp, Joyst.hpp]
2024-07-14 add kicad project
    [Micro_Rev1j.kicad_pcb, Micro_Rev1j.kicad_sch, circuit.kicad_pcb, circuit.kicad_sch]
2024-07-15 add display class
    [circuit.kicad_sch]
2024-07-15 add new project because i want to handle the 16 buttons with an other microcontroller
    [Micro_Rev1j.kicad_pcb, Micro_Rev1j.kicad_sch, circuit.kicad_pcb, circuit.kicad_sch]
2024-07-15 switch back
    [Micro_Rev1j.kicad_pcb, Micro_Rev1j.kicad_sch, circuit.kicad_pcb, circuit.kicad_sch]
2024-07-15 fix joystick button
2024-07-15 refactoring for twi buttons
2024-07-16 change the circuit
    [circuit.kicad_pcb, circuit.kicad_sch]
2024-07-19 start with setup lcd
    [circuit.kicad_pcb, circuit.kicad_sch]
2024-07-19 add some encoder stuff
2024-07-20 implement encoder set zero
2024-07-21 implement encoder
2024-07-22 fix encoder degree. but have issue with exit assetto corsa -> it will not close
    [Encoder.hpp, ProjectConfig.hpp]
2024-07-23 add next i2c button box connector
    [circuit.kicad_pcb, circuit.kicad_sch]
2024-07-23 fix issue with cycle counter
    [main.cpp]
2024-07-23 issue with encoder
2024-07-23 encoder works, but it´s pretty ugly. need to refactor it
2024-12-21 finish layout the PCB
    [circuit.kicad_pcb, circuit.kicad_sch]
2024-12-21 finish PCBA
    [circuit-B_Cu.gbr, circuit-B_Mask.gbr, circuit-B_Paste.gbr, circuit-B_Silkscreen.gbr, circuit-Edge_Cuts.gbr, circuit-F_Cu.gbr, circuit-F_Mask.gbr, circuit-F_Paste.gbr]
2024-12-21 export schematics
2024-12-23 generate doc
    [circuit-B_Cu.gbr, circuit-B_Mask.gbr, circuit-B_Paste.gbr, circuit-B_Silkscreen.gbr, circuit-Edge_Cuts.gbr, circuit-F_Cu.gbr, circuit-F_Mask.gbr, circuit-F_Paste.gbr]
2024-12-25 remove lcd and add gitignore for kicad
    [circuit-B_Cu.gbr, circuit-B_Mask.gbr, circuit-B_Paste.gbr, circuit-B_Silkscreen.gbr, circuit-Edge_Cuts.gbr, circuit-F_Cu.gbr, circuit-F_Mask.gbr, circuit-F_Paste.gbr]
2024-12-25 update pcba picture
2024-12-26 add ps4 joystick pcb + data over rj45
    [circuit-B_Cu.gbr, circuit-B_Mask.gbr, circuit-B_Paste.gbr, circuit-B_Silkscreen.gbr, circuit-Edge_Cuts.gbr, circuit-F_Cu.gbr, circuit-F_Mask.gbr, circuit-F_Paste.gbr]
2024-12-26 add picture of joystick pcb
2024-12-26 start to add button matrix to joystick pcb
    [ps4.kicad_sch]
2024-12-27 update pcb and documentation
    [ps4.kicad_pcb, ps4.kicad_sch]
2024-12-27 update joystick pcb
    [ps4.kicad_pcb, ps4.kicad_sch]
2024-12-27 add little-scale/PS4_joystick_footprint next to the footprint
    [ps4.kicad_pcb]
2024-12-29 add force feedback device to layout
    [circuit-B_Cu.gbr, circuit-B_Mask.gbr, circuit-B_Paste.gbr, circuit-B_Silkscreen.gbr, circuit-Edge_Cuts.gbr, circuit-F_Cu.gbr, circuit-F_Mask.gbr, circuit-F_Paste.gbr]
2025-01-14 update Fertigungsdaten
    [circuit-B_Cu.gbr, circuit-B_Mask.gbr, circuit-B_Paste.gbr, circuit-B_Silkscreen.gbr, circuit-Edge_Cuts.gbr, circuit-F_Cu.gbr, circuit-F_Mask.gbr, circuit-F_Paste.gbr]
2025-01-14 update release v1.0.0
    [circuit.kicad_pcb, circuit.kicad_sch, ps4.kicad_pcb, ps4.kicad_sch]
2025-02-07 upload real pcba picture
2025-03-22 fix: all 32 button works
    [Buttons.cpp]
2025-03-22 setup timer 3 for receiving data
2025-03-25 implement tolerance calculation for break and throttle
    [ADCAxis.cpp, ADCAxis.hpp, ComUsb.cpp]
2025-03-25 fix issue with display and encoder
    [ComUsb.cpp, main.cpp]
2025-03-25 return to non corrected joystick
    [ComUsb.cpp]
2025-03-26 i have a stack overflow issue above 2140 bytes of RAM
    [ADCAxis.cpp, ADCAxis.hpp, ComUsb.cpp, Joyst.cpp, Joyst.hpp, SetupDisplay.cpp, SetupDisplay.hpp, TextBoxes.h]
2025-03-30 change Setup routine to a i2c device - saving RAM and FLASH storage
2025-04-03 fix issue with other pcs recognizing the controller
    [ComUsb.cpp]
2025-04-03 handle the tolerance setting for the pedals with adc class
    [ADCAxis.cpp, ADCAxis.hpp, ProjectConfig.hpp, SetupDisplay.cpp]
2025-05-10 optimize ps4 joystick pcb
    [ps4.kicad_pcb, ps4.kicad_sch]
2025-05-10 generate PCB assembly data for v1.1.0
    [circuit.kicad_pcb, circuit.kicad_sch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]
